UNL-Lunabotics/Electrical-26-27/README.md

# Electrical-26-27
Electrical's pcb projects and documentation.
