UNL-Lunabotics/Electrical-26-27/Motor_Driver/Motor_Driver.kicad_pcb

## KiCad design Motor_Driver/Motor_Driver.kicad_pcb (2026-11-14)

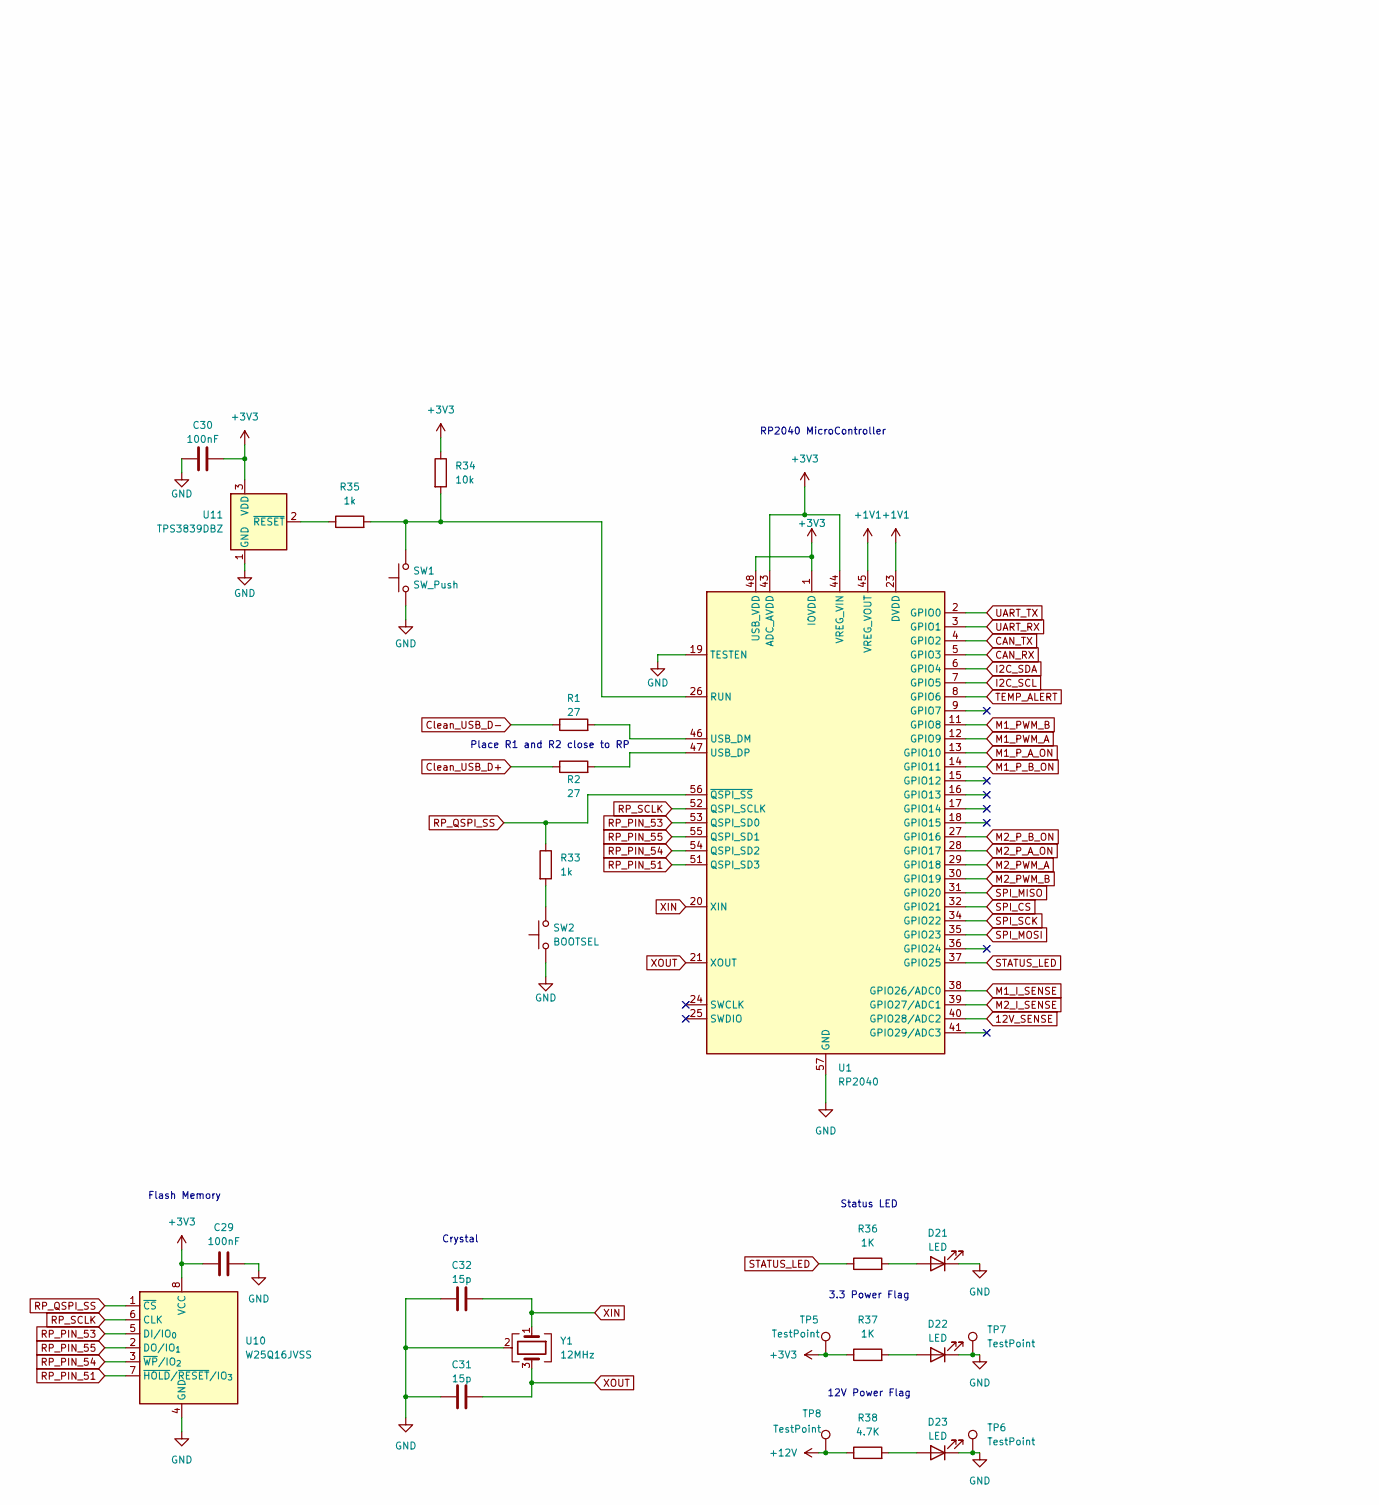
[picture p1: schematic Motor_Driver.kicad_sch, part in row 1, column 1]

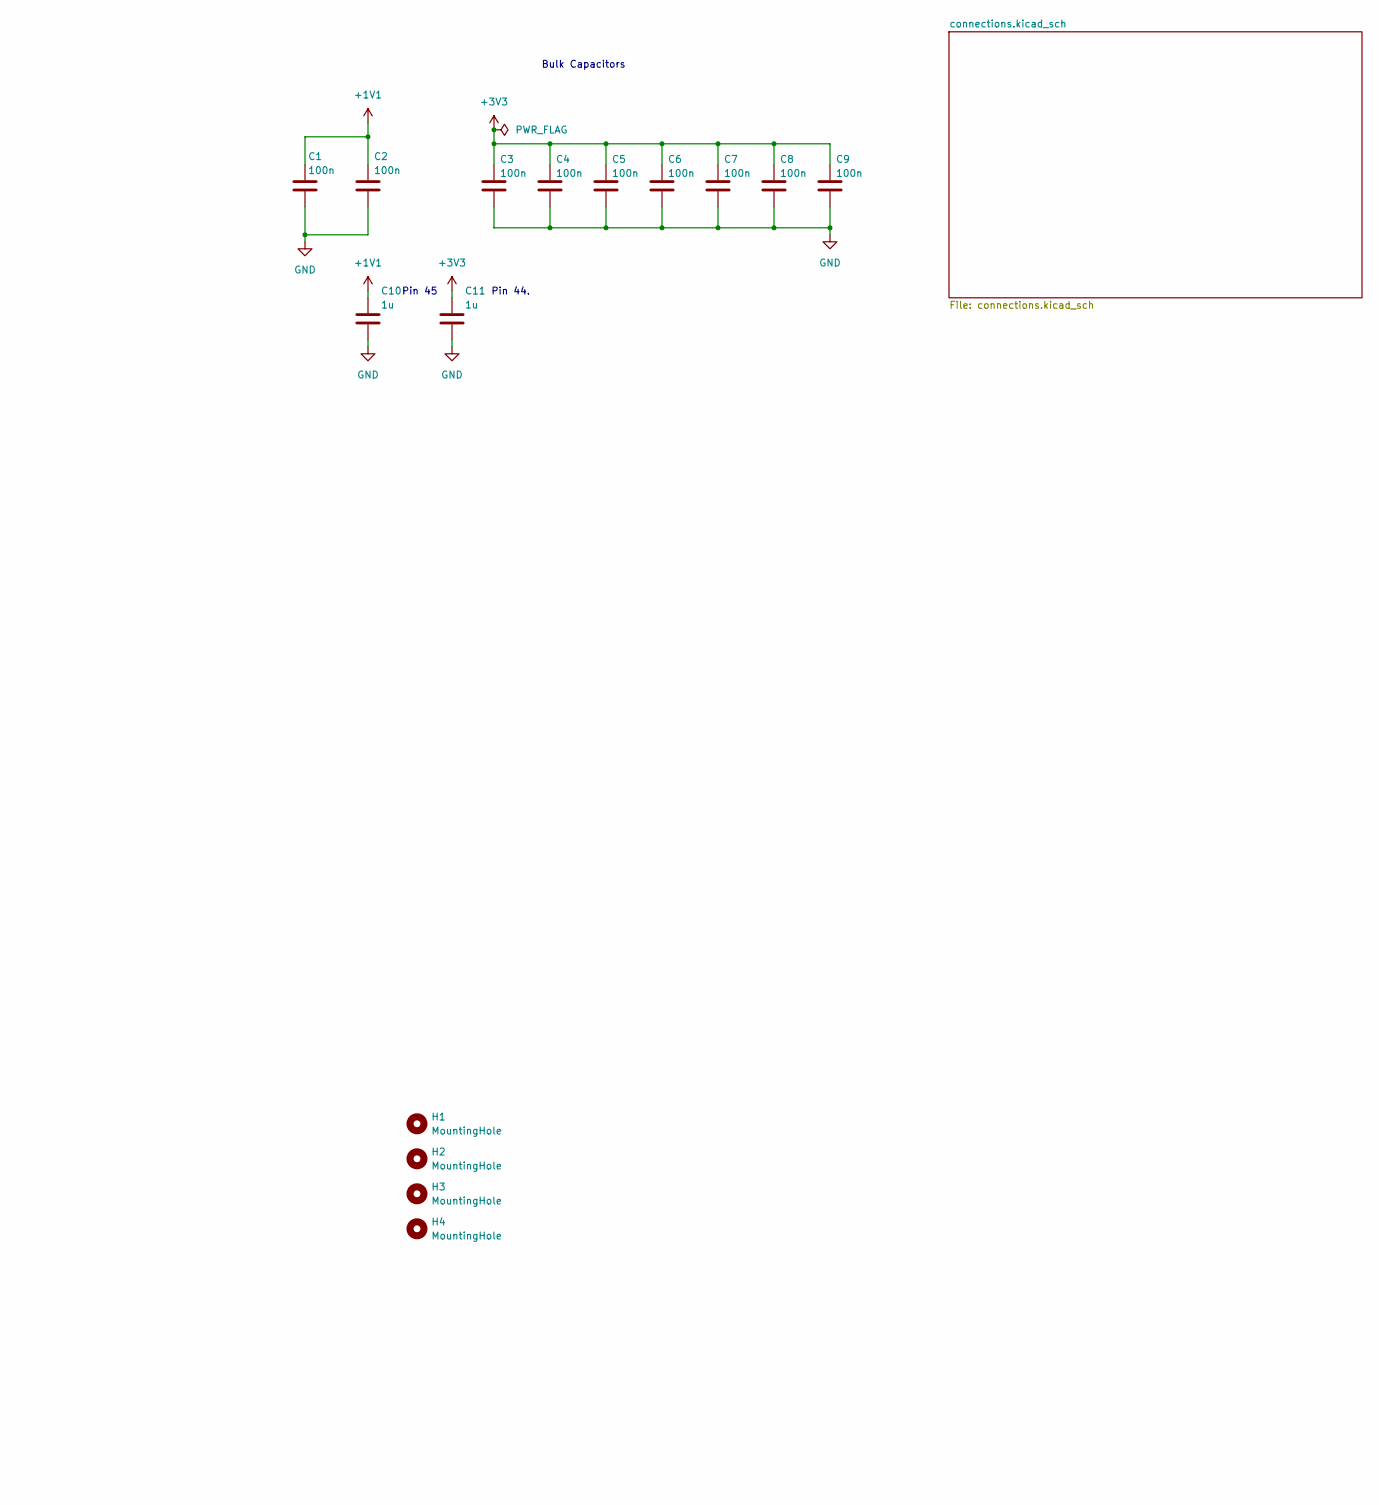
[picture p2: schematic Motor_Driver.kicad_sch, part in row 1, column 2]

Parts:
C1, C2, C3, C4, C5, C6, C7, C8, C9: 100n; C_0805_2012Metric
C10, C11: 1u; C_0805_2012Metric
C29, C30: 100nF; C_0805_2012Metric
C31, C32: 15p; C_0805_2012Metric
D21, D22, D23: LED; LED_0805_2012Metric
H1, H2, H3, H4: MountingHole; MountingHole_3.2mm_M3
R1, R2: 27; R_0805_2012Metric
R33, R35: 1k; R_0805_2012Metric
R34: 10k; R_0805_2012Metric
R36, R37: 1K; R_0805_2012Metric
R38: 4.7K; R_0805_2012Metric
SW1: SW_Push; SW_PUSH_6mm
SW2: BOOTSEL; SW_PUSH_6mm
TP5, TP6, TP7, TP8: TestPoint; TestPoint_Pad_D1.5mm
U1: RP2040; QFN-56-1EP_7x7mm_P0.4mm_EP3.2x3.2mm
U10: W25Q16JVSS; SOIC-8_5.3x5.3mm_P1.27mm
U11: TPS3839DBZ; SOT-23
Y1: 12MHz; Crystal_SMD_3225-4Pin_3.2x2.5mm

Connections:
12V_SENSE: U1.40 (GPIO28/ADC2); also elsewhere on the board
+1V1: C1.1, C2.1, C10.1, U1.23 (DVDD), U1.45 (VREG_VOUT), U1.50 (DVDD)
+3V3: C3.1, C4.1, C5.1, C6.1, C7.1, C8.1, C9.1, C11.1, C29.1, C30.1, R34.1, R37.1, TP5.1 (1_1), U1.1 (IOVDD), U1.10 (IOVDD), U1.22 (IOVDD), U1.33 (IOVDD), U1.42 (IOVDD), U1.43 (ADC_AVDD), U1.44 (VREG_VIN), U1.48 (USB_VDD), U1.49 (IOVDD), U10.8 (VCC), U11.3 (VDD); also elsewhere on the board
+12V: R38.1, TP8.1 (1_1); also elsewhere on the board
CAN_RX: U1.5 (GPIO3); also elsewhere on the board
CAN_TX: U1.4 (GPIO2); also elsewhere on the board
Clean_USB_D+: R2.1; also elsewhere on the board
Clean_USB_D-: R1.1; also elsewhere on the board
GND: C1.2, C2.2, C3.2, C4.2, C5.2, C6.2, C7.2, C8.2, C9.2, C10.2, C11.2, C29.2, C30.2, C31.1, C32.1, D21.1 (K), D22.1 (K), D23.1 (K), SW1.1, SW2.1, TP6.1 (1_1), TP7.1 (1_1), U1.19 (TESTEN), U1.57 (GND), U10.4 (GND), U11.1 (GND), Y1.2 (G), Y1.4 (G); also elsewhere on the board
I2C_SCL: U1.7 (GPIO5); also elsewhere on the board
I2C_SDA: U1.6 (GPIO4); also elsewhere on the board
M1_I_SENSE: U1.38 (GPIO26/ADC0); also elsewhere on the board
M1_PWM_A: U1.12 (GPIO9); also elsewhere on the board
M1_PWM_B: U1.11 (GPIO8); also elsewhere on the board
M1_P_A_ON: U1.13 (GPIO10); also elsewhere on the board
M1_P_B_ON: U1.14 (GPIO11); also elsewhere on the board
M2_I_SENSE: U1.39 (GPIO27/ADC1); also elsewhere on the board
M2_PWM_A: U1.29 (GPIO18); also elsewhere on the board
M2_PWM_B: U1.30 (GPIO19); also elsewhere on the board
M2_P_A_ON: U1.28 (GPIO17); also elsewhere on the board
M2_P_B_ON: U1.27 (GPIO16); also elsewhere on the board
unnamed: D21.2 (A), R36.2
unnamed: D22.2 (A), R37.2
unnamed: D23.2 (A), R38.2
unnamed: R33.2, SW2.2
unnamed: R34.2, R35.2, SW1.2, U1.26 (RUN)
unnamed: R1.2, U1.46 (USB_DM)
unnamed: R2.2, U1.47 (USB_DP)
unnamed: R35.1, U11.2 (~RESET)
RP_PIN_51: U1.51 (QSPI_SD3), U10.7 (~HOLD/~RESET/IO_{3})
RP_PIN_53: U1.53 (QSPI_SD0), U10.5 (DI/IO_{0})
RP_PIN_54: U1.54 (QSPI_SD2), U10.3 (~WP/IO_{2})
RP_PIN_55: U1.55 (QSPI_SD1), U10.2 (DO/IO_{1})
RP_QSPI_SS: R33.1, U1.56 (~QSPI_SS), U10.1 (~CS)
RP_SCLK: U1.52 (QSPI_SCLK), U10.6 (CLK)
SPI_CS: U1.32 (GPIO21); also elsewhere on the board
SPI_MISO: U1.31 (GPIO20); also elsewhere on the board
SPI_MOSI: U1.35 (GPIO23); also elsewhere on the board
SPI_SCK: U1.34 (GPIO22); also elsewhere on the board
STATUS_LED: R36.1, U1.37 (GPIO25)
TEMP_ALERT: U1.8 (GPIO6); also elsewhere on the board
UART_RX: U1.3 (GPIO1); also elsewhere on the board
UART_TX: U1.2 (GPIO0); also elsewhere on the board
XIN: C32.2, U1.20 (XIN), Y1.1
XOUT: C31.2, U1.21 (XOUT), Y1.3

Notes on the sheet:
Pin 44.
12V Power Flag
Pin 45
Bulk Capacitors
Status LED
3.3 Power Flag
Flash Memory
Crystal
RP2040 MicroController
Place R1 and R2 close to RP

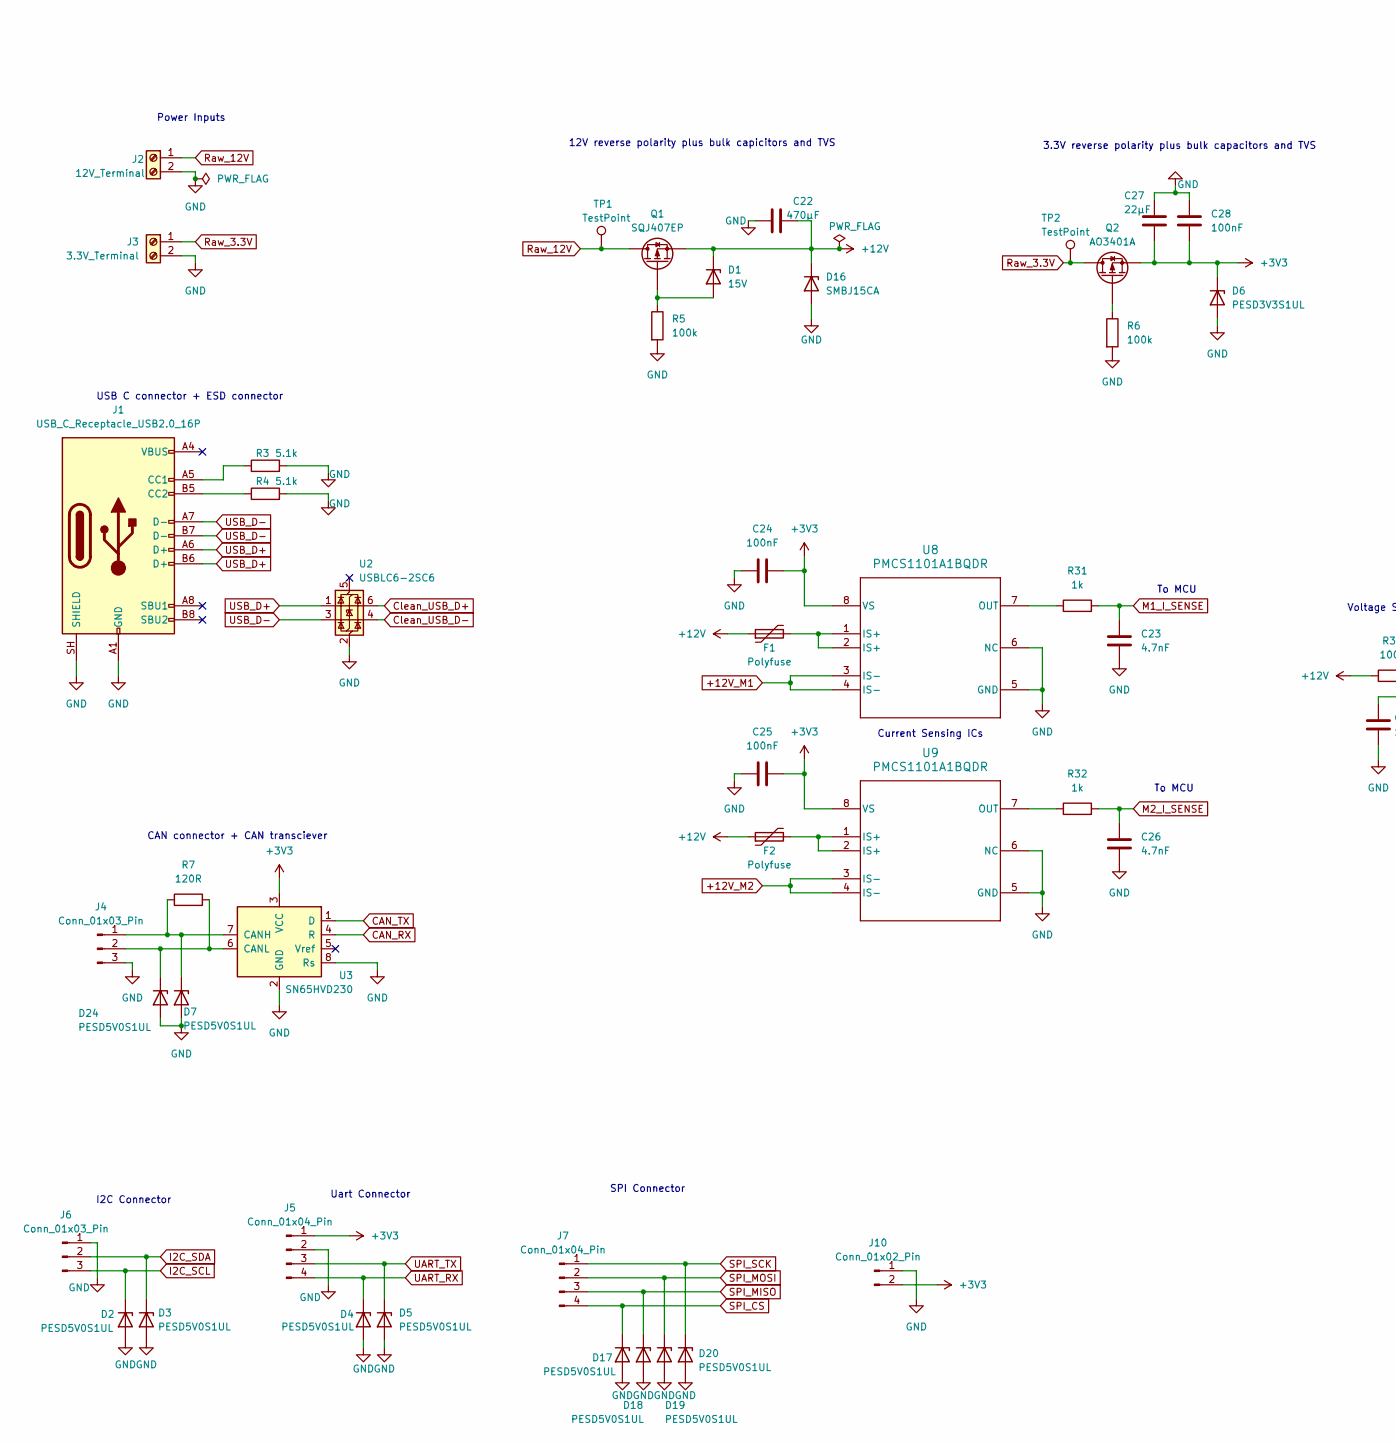
[picture p3: schematic connections.kicad_sch, part in row 1, column 1]

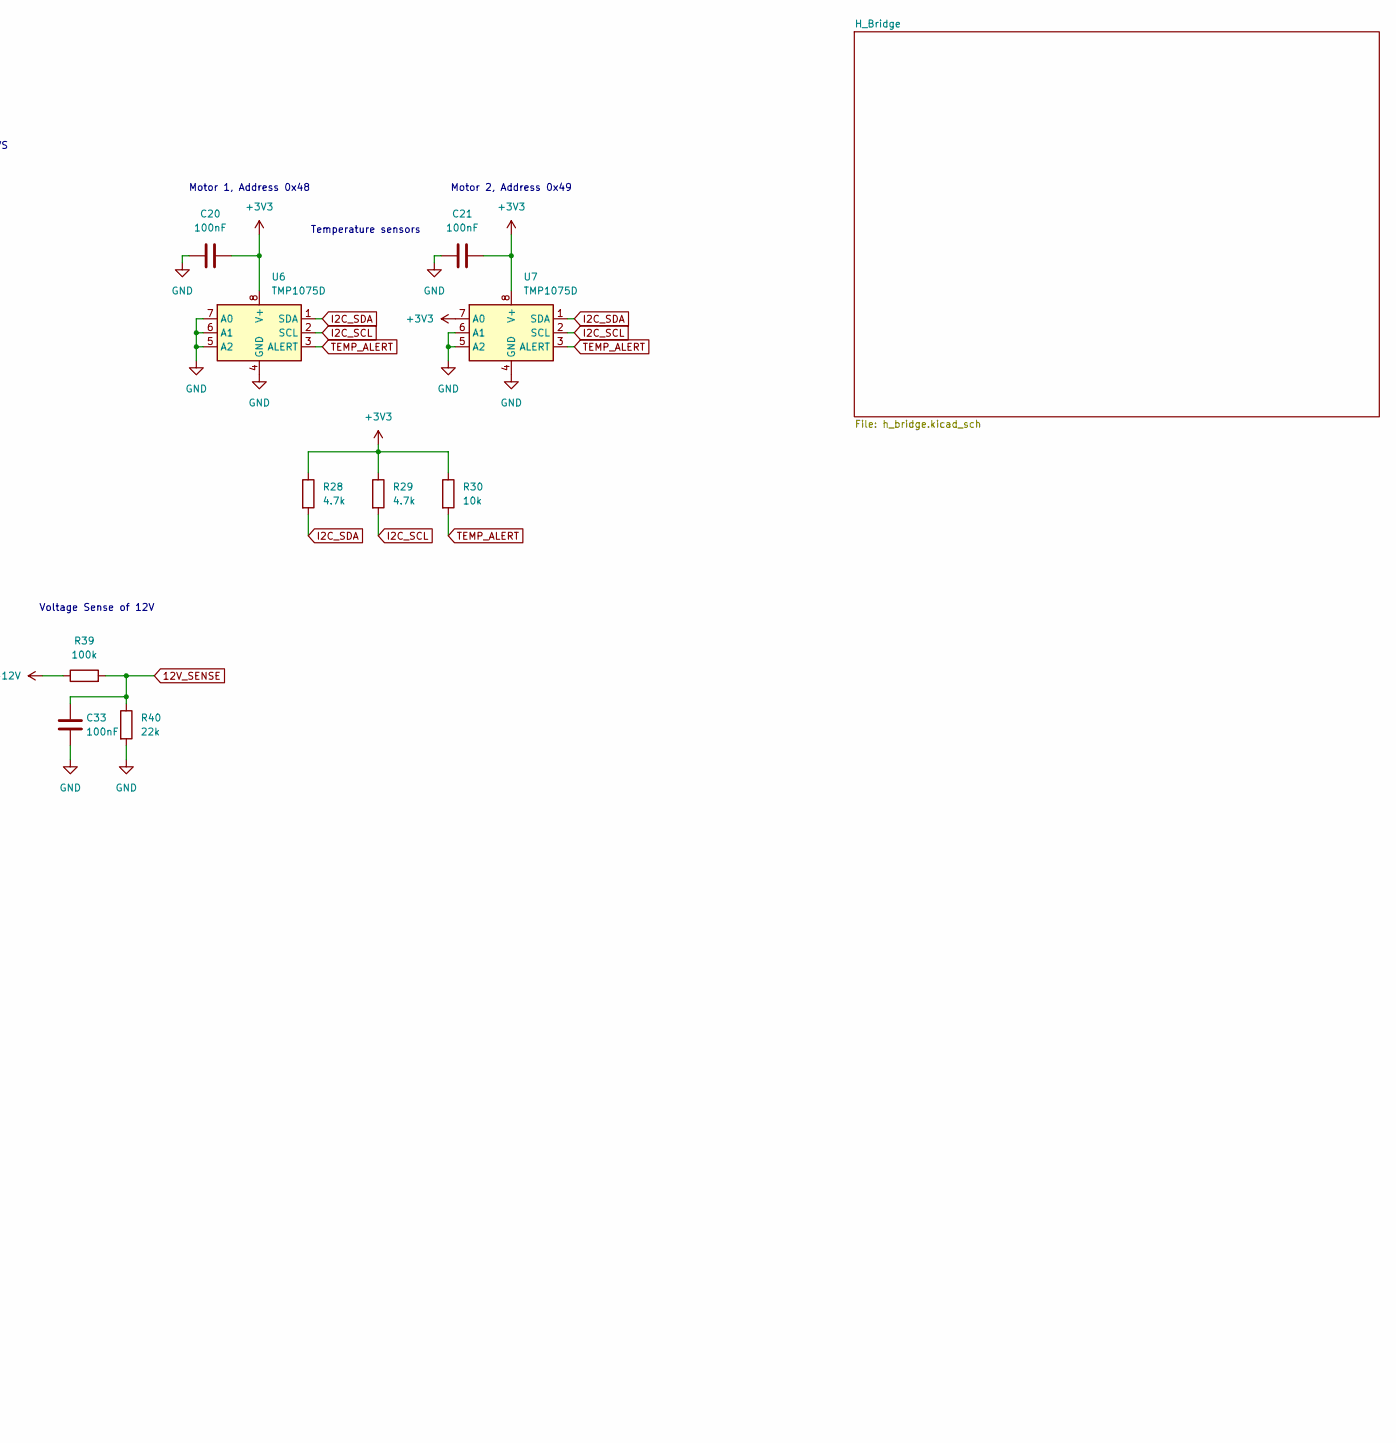
[picture p4: schematic connections.kicad_sch, part in row 1, column 2]

Parts:
C20, C21, C24, C25, C28, C33: 100nF; C_0805_2012Metric
C22: 470μF; CP_Elec_10x10.5
C23, C26: 4.7nF; C_0805_2012Metric
C27: 22μF; C_0805_2012Metric
D1: 15V; D_SOD-123
D2, D3, D4, D5, D7, D17, D18, D19, D20, D24: PESD5V0S1UL; D_SOD-882
D6: PESD3V3S1UL; D_SOD-882
D16: SMBJ15CA; D_SMB
F1, F2: Polyfuse; Fuse_Mount
J1: USB_C_Receptacle_USB2.0_16P; USB_C_Receptacle_GCT_USB4105-xx-A_16P_TopMnt_Horizontal
J2: 12V_Terminal; TerminalBlock_MaiXu_MX126-5.0-02P_1x02_P5.00mm
J3: 3.3V_Terminal; TerminalBlock_MaiXu_MX126-5.0-02P_1x02_P5.00mm
J4, J6: Conn_01x03_Pin; JST_XH_B3B-XH-A_1x03_P2.50mm_Vertical
J5, J7: Conn_01x04_Pin; JST_XH_B4B-XH-A_1x04_P2.50mm_Vertical
J10: Conn_01x02_Pin; JST_XH_B2B-XH-A_1x02_P2.50mm_Vertical
Q1: SQJ407EP; PowerPAK_SO-8_Single_SGD
Q2: AO3401A; SOT-23_GSD
R3, R4: 5.1k; R_0805_2012Metric
R5, R6, R39: 100k; R_0805_2012Metric
R7: 120R; R_0805_2012Metric
R28, R29: 4.7k; R_0805_2012Metric
R30: 10k; R_0805_2012Metric
R31, R32: 1k; R_0805_2012Metric
R40: 22k; R_0805_2012Metric
TP1, TP2: TestPoint; TestPoint_Pad_D1.5mm
U2: USBLC6-2SC6; SOT-23-6
U3: SN65HVD230; SOIC-8_3.9x4.9mm_P1.27mm
U6, U7: TMP1075D; SO-8_3.9x4.9mm_P1.27mm
U8, U9: PMCS1101A1BQDR; D0008A_N

Connections:
12V_SENSE: C33.1, R39.2, R40.1; also elsewhere on the board
+3V3: C20.2, C21.2, C24.2, C25.2, C27.2, C28.2, D6.1 (K), J5.1, J10.2, Q2.S, R28.1, R29.1, R30.1, U3.3 (VCC), U6.8 (V+), U7.7 (A0), U7.8 (V+), U8.8 (VS), U9.8 (VS); also elsewhere on the board
+12V: C22.2, D1.1 (K), D16.1 (K), F1.1, F2.1, Q1.S, R39.1; also elsewhere on the board
+12V_M1: U8.3 (IS-), U8.4 (IS-); also elsewhere on the board
+12V_M2: U9.3 (IS-), U9.4 (IS-); also elsewhere on the board
CAN_RX: U3.4 (R); also elsewhere on the board
CAN_TX: U3.1 (D); also elsewhere on the board
Clean_USB_D+: U2.6 (I/O1); also elsewhere on the board
Clean_USB_D-: U2.4 (I/O2); also elsewhere on the board
GND: C20.1, C21.1, C22.1, C23.2, C24.1, C25.1, C26.2, C27.1, C28.1, C33.2, D2.2 (A), D3.2 (A), D4.2 (A), D5.2 (A), D6.2 (A), D7.2 (A), D16.2 (A), D17.2 (A), D18.2 (A), D19.2 (A), D20.2 (A), D24.2 (A), J1.A1 (GND), J1.A12 (GND), J1.B1 (GND), J1.B12 (GND), J1.SH (SHIELD), J2.2, J3.2, J4.3, J5.2, J6.1, J10.1, R3.2, R4.2, R5.2, R6.2, R40.2, U2.2 (GND), U3.2 (GND), U3.8 (Rs), U6.4 (GND), U6.5 (A2), U6.6 (A1), U6.7 (A0), U7.4 (GND), U7.5 (A2), U7.6 (A1), U8.5 (GND), U8.6 (NC), U9.5 (GND), U9.6 (NC); also elsewhere on the board
I2C_SCL: D2.1 (K), J6.3, R29.2, U6.2 (SCL), U7.2 (SCL); also elsewhere on the board
I2C_SDA: D3.1 (K), J6.2, R28.2, U6.1 (SDA), U7.1 (SDA); also elsewhere on the board
M1_I_SENSE: C23.1, R31.2; also elsewhere on the board
M2_I_SENSE: C26.1, R32.2; also elsewhere on the board
unnamed: D1.2 (A), Q1.G, R5.1
unnamed: D7.1 (K), J4.1, R7.1, U3.7 (CANH)
unnamed: D24.1 (K), J4.2, R7.2, U3.6 (CANL)
unnamed: F1.2, U8.1 (IS+), U8.2 (IS+)
unnamed: F2.2, U9.1 (IS+), U9.2 (IS+)
unnamed: J1.A5 (CC1), R3.1
unnamed: J1.B5 (CC2), R4.1
unnamed: Q2.G, R6.1
unnamed: R31.1, U8.7 (OUT)
unnamed: R32.1, U9.7 (OUT)
Raw_3.3V: J3.1, Q2.D, TP2.1 (1_1)
Raw_12V: J2.1, Q1.D, TP1.1 (1_1)
SPI_CS: D17.1 (K), J7.4; also elsewhere on the board
SPI_MISO: D18.1 (K), J7.3; also elsewhere on the board
SPI_MOSI: D19.1 (K), J7.2; also elsewhere on the board
SPI_SCK: D20.1 (K), J7.1; also elsewhere on the board
TEMP_ALERT: R30.2, U6.3 (ALERT), U7.3 (ALERT); also elsewhere on the board
UART_RX: D4.1 (K), J5.4; also elsewhere on the board
UART_TX: D5.1 (K), J5.3; also elsewhere on the board
USB_D+: J1.A6 (D+), J1.B6 (D+), U2.1 (I/O1)
USB_D-: J1.A7 (D-), J1.B7 (D-), U2.3 (I/O2)

Notes on the sheet:
Temperature sensors
Motor 1, Address 0x48
I2C Connector
To MCU
USB C connector + ESD connector
3.3V reverse polarity plus bulk capacitors and TVS
12V reverse polarity plus bulk capicitors and TVS
Current Sensing ICs
Motor 2, Address 0x49
CAN connector + CAN transciever
Power Inputs
Voltage Sense of 12V
SPI Connector
Uart Connector

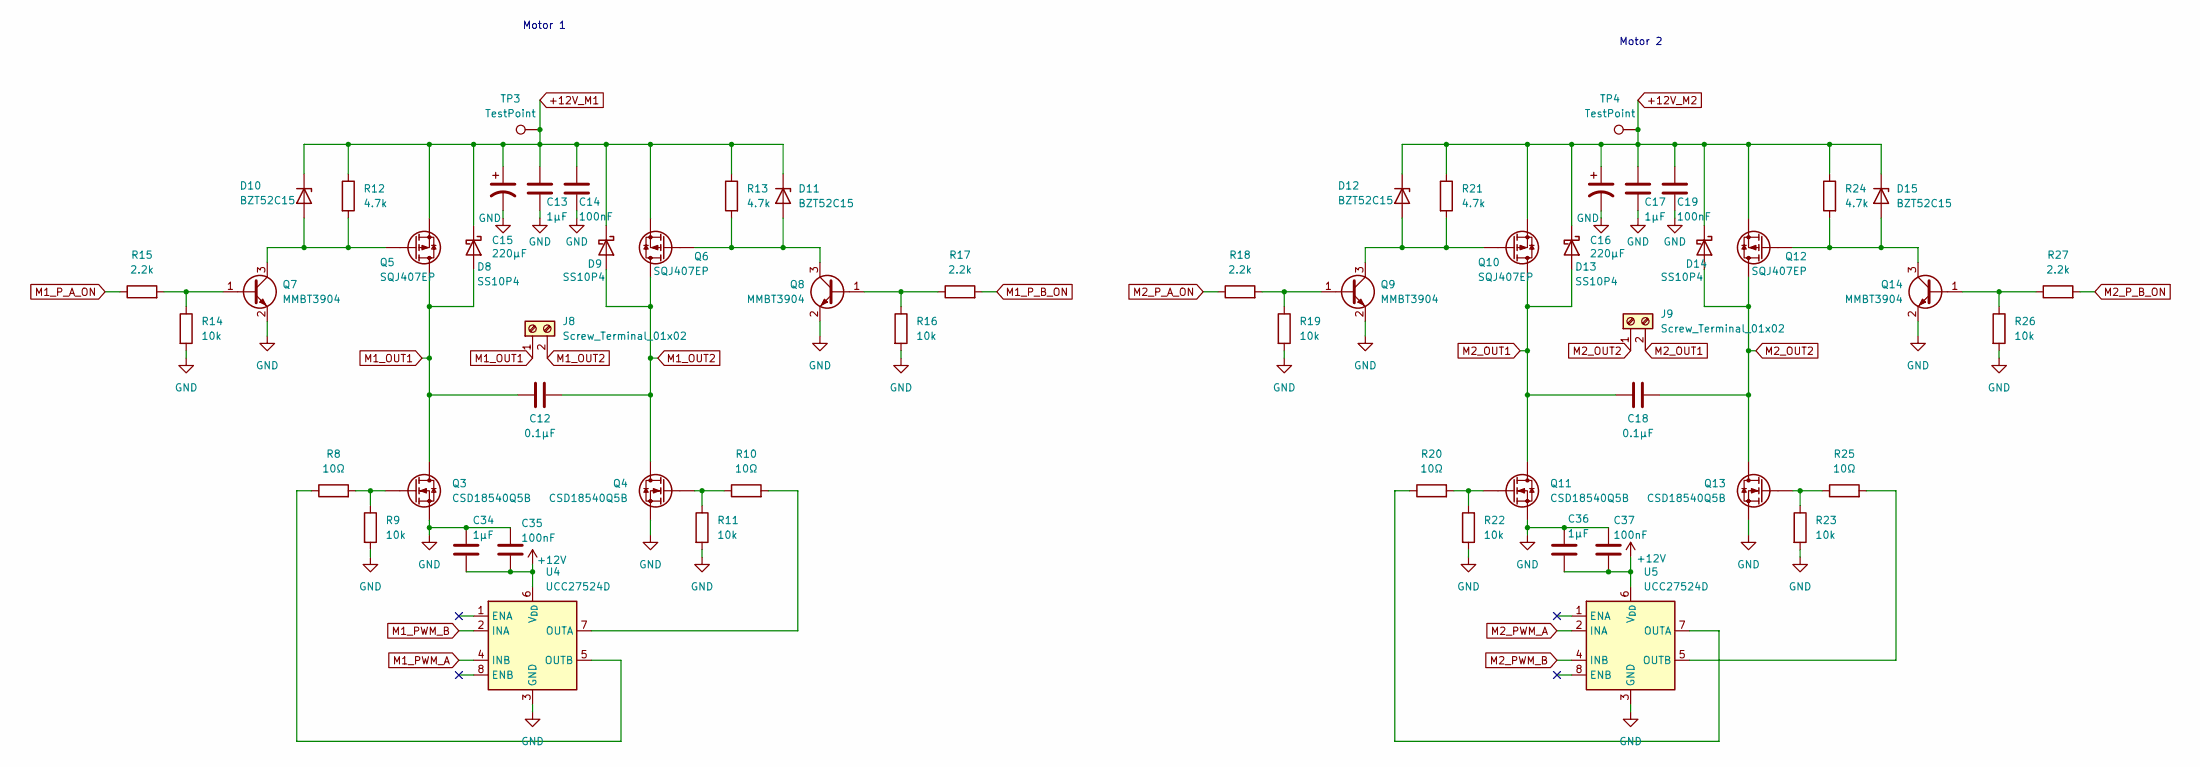
[picture p5: schematic h_bridge.kicad_sch]

Parts:
C12, C18: 0.1μF; C_0805_2012Metric
C13, C17, C34, C36: 1μF; C_0805_2012Metric
C14, C19, C35, C37: 100nF; C_0805_2012Metric
C15, C16: 220μF; CP_Elec_8x10.5
D8, D9, D13, D14: SS10P4; TO-277A_SS10P4_K-tab
D10, D11, D12, D15: BZT52C15; D_SOD-123
J8, J9: Screw_Terminal_01x02; TerminalBlock_MaiXu_MX126-5.0-02P_1x02_P5.00mm
Q3, Q4, Q11, Q13: CSD18540Q5B; TDSON-8-1_SGD
Q5, Q6, Q10, Q12: SQJ407EP; PowerPAK_SO-8_Single_SGD
Q7, Q8, Q9, Q14: MMBT3904; SOT-23
R8, R10, R20, R25: 10Ω; R_0805_2012Metric
R9, R11, R14, R16, R19, R22, R23, R26: 10k; R_0805_2012Metric
R12, R13, R21, R24: 4.7k; R_0805_2012Metric
R15, R17, R18, R27: 2.2k; R_0805_2012Metric
TP3, TP4: TestPoint; TestPoint_Pad_D1.5mm
U4, U5: UCC27524D; SOIC-8_3.9x4.9mm_P1.27mm

Connections:
+12V: C34.2, C35.2, C36.2, C37.2, U4.6 (V_{DD}), U5.6 (V_{DD}); also elsewhere on the board
+12V_M1: C13.1, C14.1, C15.1, D8.1 (K), D9.1 (K), D10.1 (K), D11.1 (K), Q5.S, Q6.S, R12.1, R13.1, TP3.1 (1_1); also elsewhere on the board
+12V_M2: C16.1, C17.1, C19.1, D12.1 (K), D13.1 (K), D14.1 (K), D15.1 (K), Q10.S, Q12.S, R21.1, R24.1, TP4.1 (1_1); also elsewhere on the board
GND: C13.2, C14.2, C15.2, C16.2, C17.2, C19.2, C34.1, C35.1, C36.1, C37.1, Q3.S, Q4.S, Q7.2 (E), Q8.2 (E), Q9.2 (E), Q11.S, Q13.S, Q14.2 (E), R9.2, R11.2, R14.2, R16.2, R19.2, R22.2, R23.2, R26.2, U4.3 (GND), U5.3 (GND); also elsewhere on the board
M1_OUT1: C12.1, D8.2 (A), J8.1, Q3.D, Q5.D
M1_OUT2: C12.2, D9.2 (A), J8.2, Q4.D, Q6.D
M1_PWM_A: U4.4 (INB); also elsewhere on the board
M1_PWM_B: U4.2 (INA); also elsewhere on the board
M1_P_A_ON: R15.1; also elsewhere on the board
M1_P_B_ON: R17.2; also elsewhere on the board
M2_OUT1: C18.1, D13.2 (A), J9.2, Q10.D, Q11.D
M2_OUT2: C18.2, D14.2 (A), J9.1, Q12.D, Q13.D
M2_PWM_A: U5.2 (INA); also elsewhere on the board
M2_PWM_B: U5.4 (INB); also elsewhere on the board
M2_P_A_ON: R18.1; also elsewhere on the board
M2_P_B_ON: R27.2; also elsewhere on the board
unnamed: D10.2 (A), Q5.G, Q7.3 (C), R12.2
unnamed: D11.2 (A), Q6.G, Q8.3 (C), R13.2
unnamed: D12.2 (A), Q9.3 (C), Q10.G, R21.2
unnamed: D15.2 (A), Q12.G, Q14.3 (C), R24.2
unnamed: Q3.G, R8.2, R9.1
unnamed: Q4.G, R10.1, R11.1
unnamed: Q7.1 (B), R14.1, R15.2
unnamed: Q8.1 (B), R16.1, R17.1
unnamed: Q9.1 (B), R18.2, R19.1
unnamed: Q11.G, R20.2, R22.1
unnamed: Q13.G, R23.1, R25.1
unnamed: Q14.1 (B), R26.1, R27.1
unnamed: R10.2, U4.7 (OUTA)
unnamed: R8.1, U4.5 (OUTB)
unnamed: R20.1, U5.7 (OUTA)
unnamed: R25.2, U5.5 (OUTB)

Notes on the sheet:
Motor 1
Motor 2

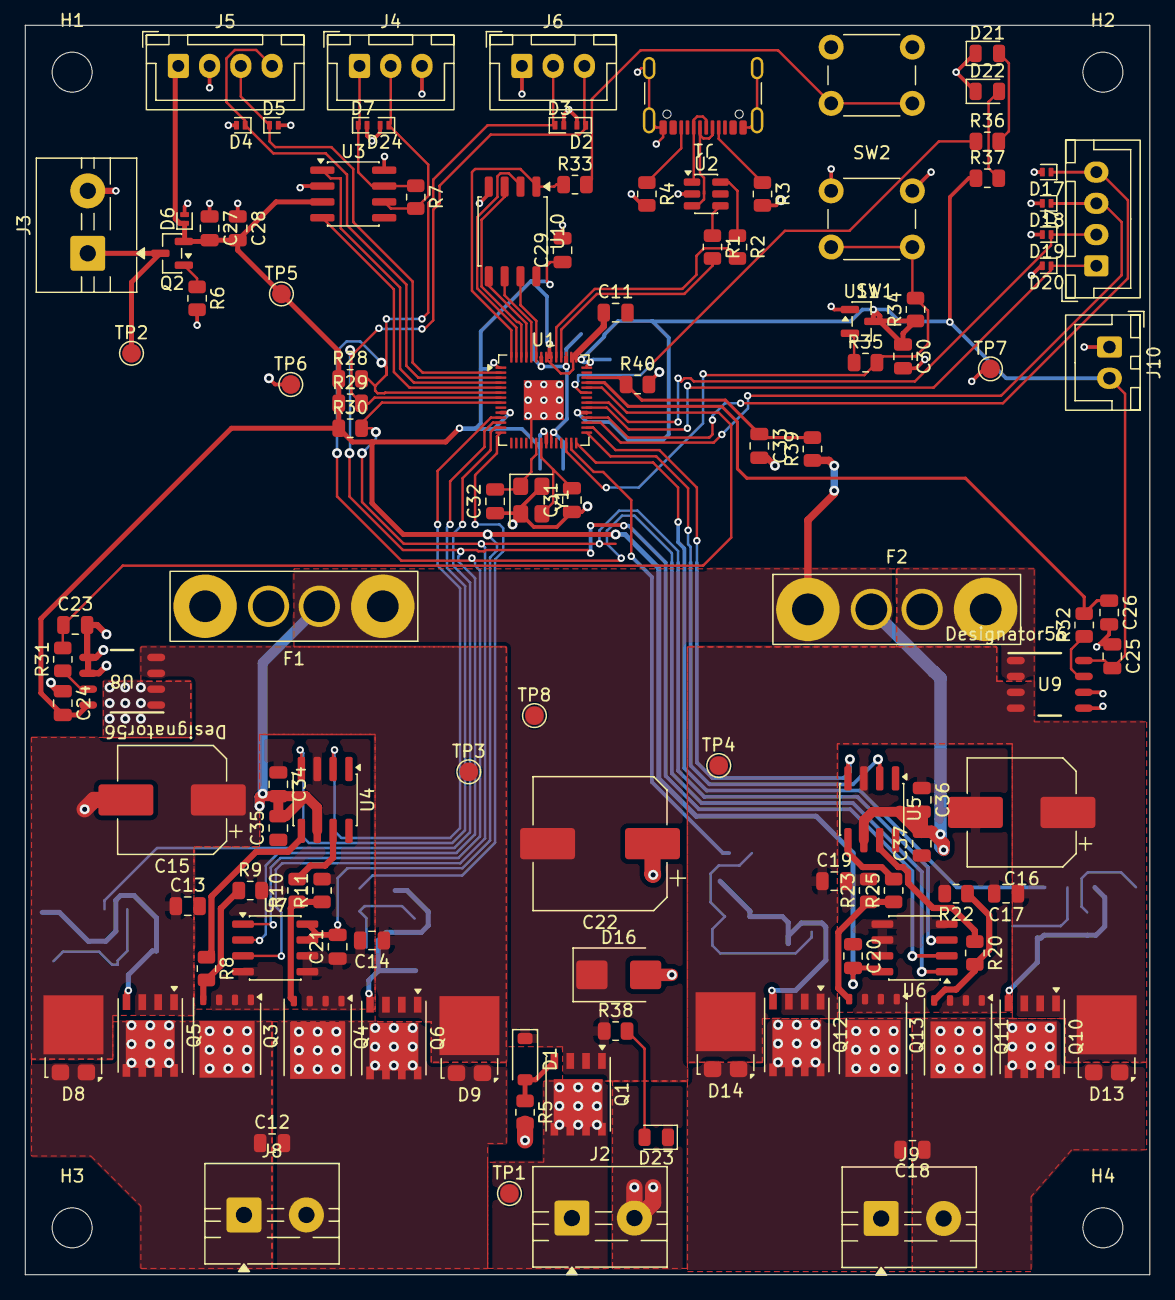
[picture p6: board Motor_Driver.kicad_pcb from above]

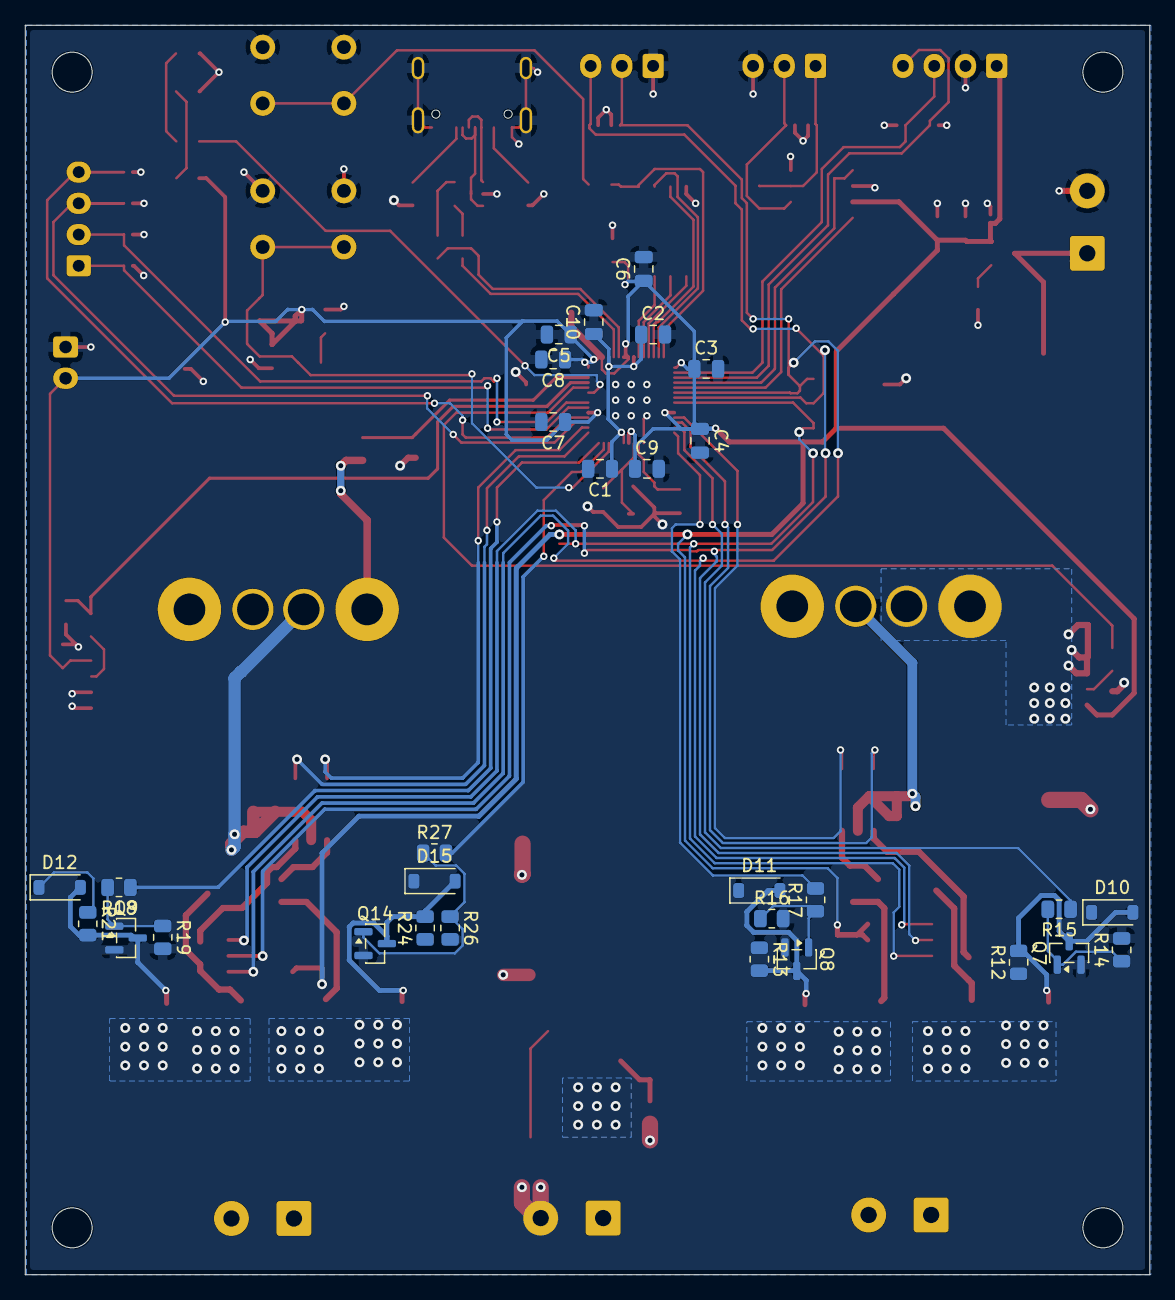
[picture p7: board Motor_Driver.kicad_pcb from below]

Board: 2 copper layers, 90.0 x 100.0 mm, 153 parts (30 on the bottom side), 81 nets.
