UNL-Lunabotics/Electrical-26-27/Motor Driver/Motor_Driver/Motor_Driver.kicad_sch

## KiCad design Motor Driver/Motor_Driver/Motor_Driver.kicad_sch (2026-10-11)

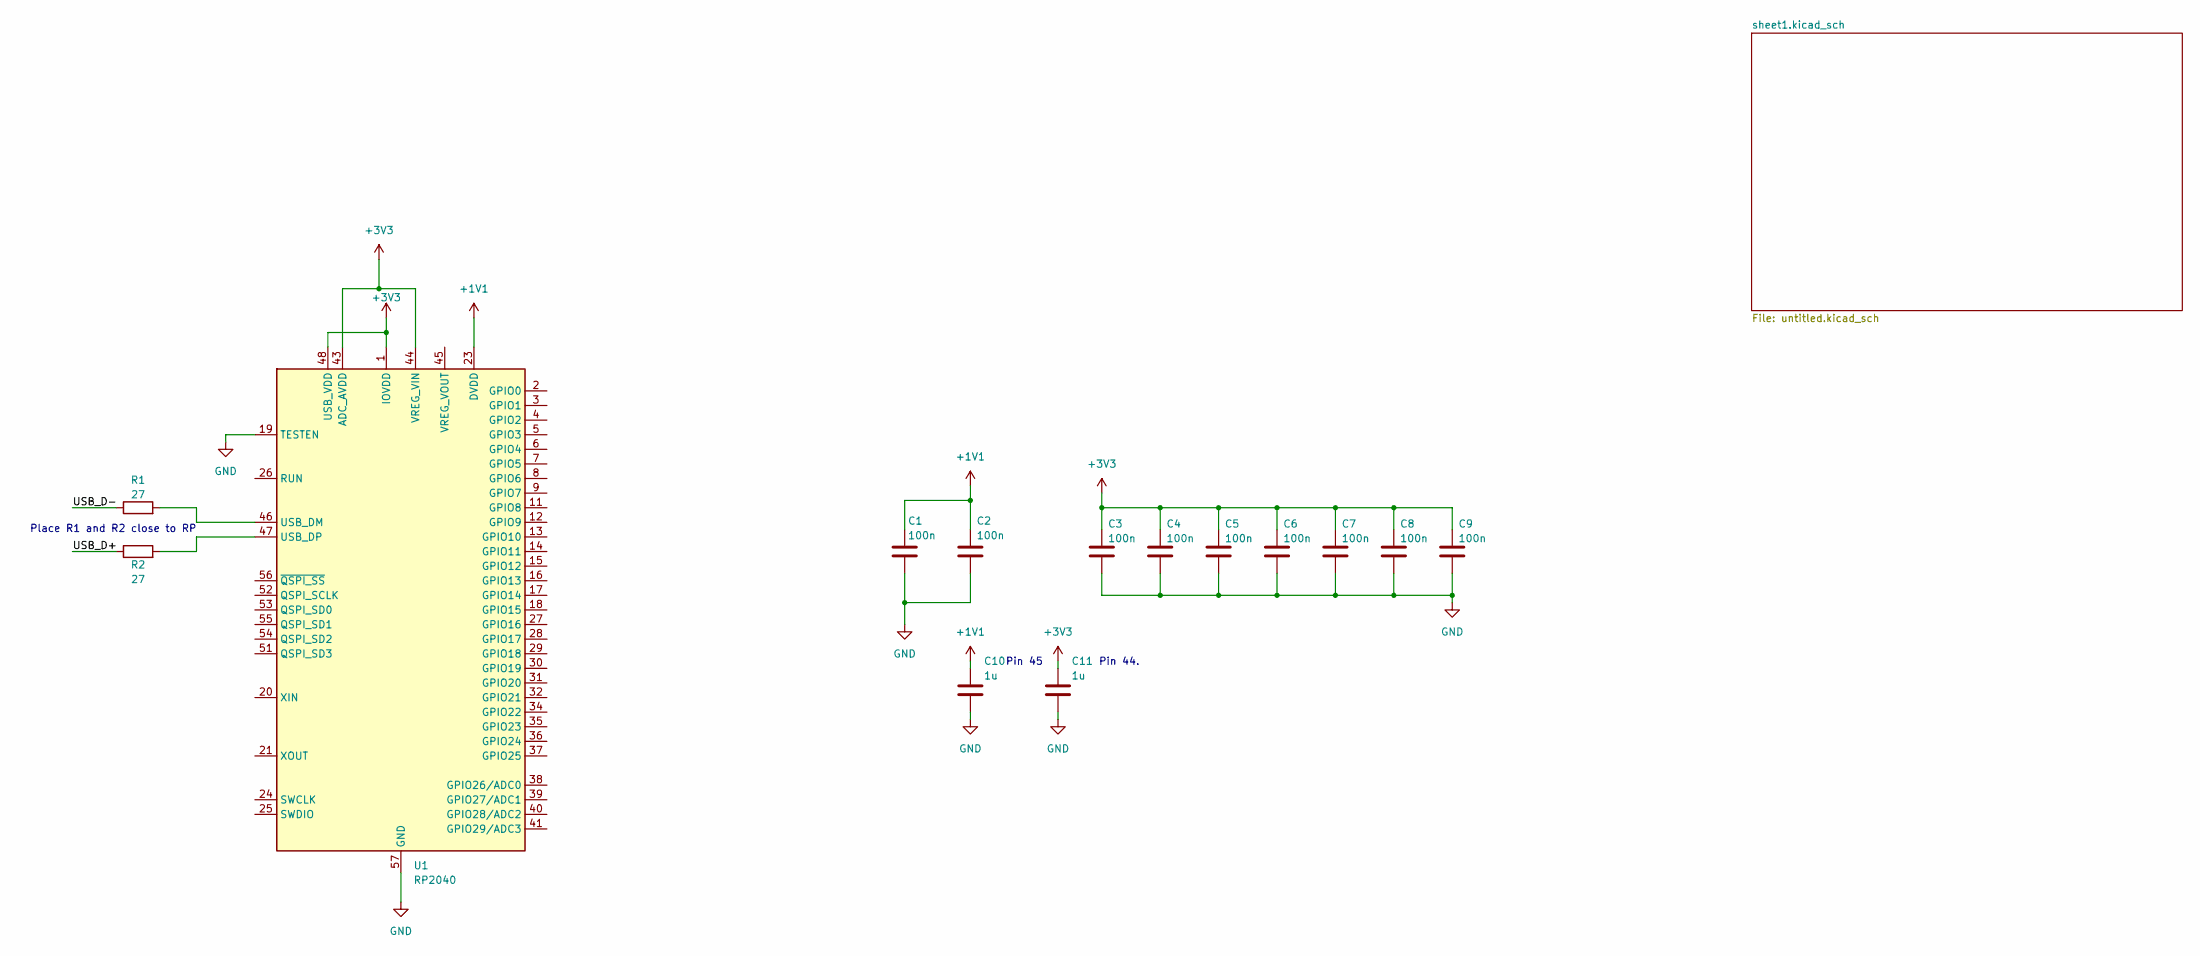
[picture p8: schematic Motor_Driver.kicad_sch]

Parts:
C1, C2, C3, C4, C5, C6, C7, C8, C9: 100n
C10, C11: 1u
R1, R2: 27
U1: RP2040; QFN-56-1EP_7x7mm_P0.4mm_EP3.2x3.2mm

Connections:
+1V1: C1.1, C2.1, C10.1, U1.23 (DVDD), U1.50 (DVDD)
+3V3: C3.1, C4.1, C5.1, C6.1, C7.1, C8.1, C9.1, C11.1, U1.1 (IOVDD), U1.10 (IOVDD), U1.22 (IOVDD), U1.33 (IOVDD), U1.42 (IOVDD), U1.43 (ADC_AVDD), U1.44 (VREG_VIN), U1.48 (USB_VDD), U1.49 (IOVDD)
GND: C1.2, C2.2, C3.2, C4.2, C5.2, C6.2, C7.2, C8.2, C9.2, C10.2, C11.2, U1.19 (TESTEN), U1.57 (GND)
unnamed: R1.2, U1.46 (USB_DM)
unnamed: R2.2, U1.47 (USB_DP)
USB_D+: R2.1
USB_D-: R1.1

Notes on the sheet:
Pin 44.
Pin 45
Place R1 and R2 close to RP
