UNL-Lunabotics/Electrical-26-27/Motor Driver/Motor_Driver/untitled.kicad_sch

## KiCad design Motor Driver/Motor_Driver/untitled.kicad_sch (2026-10-11)

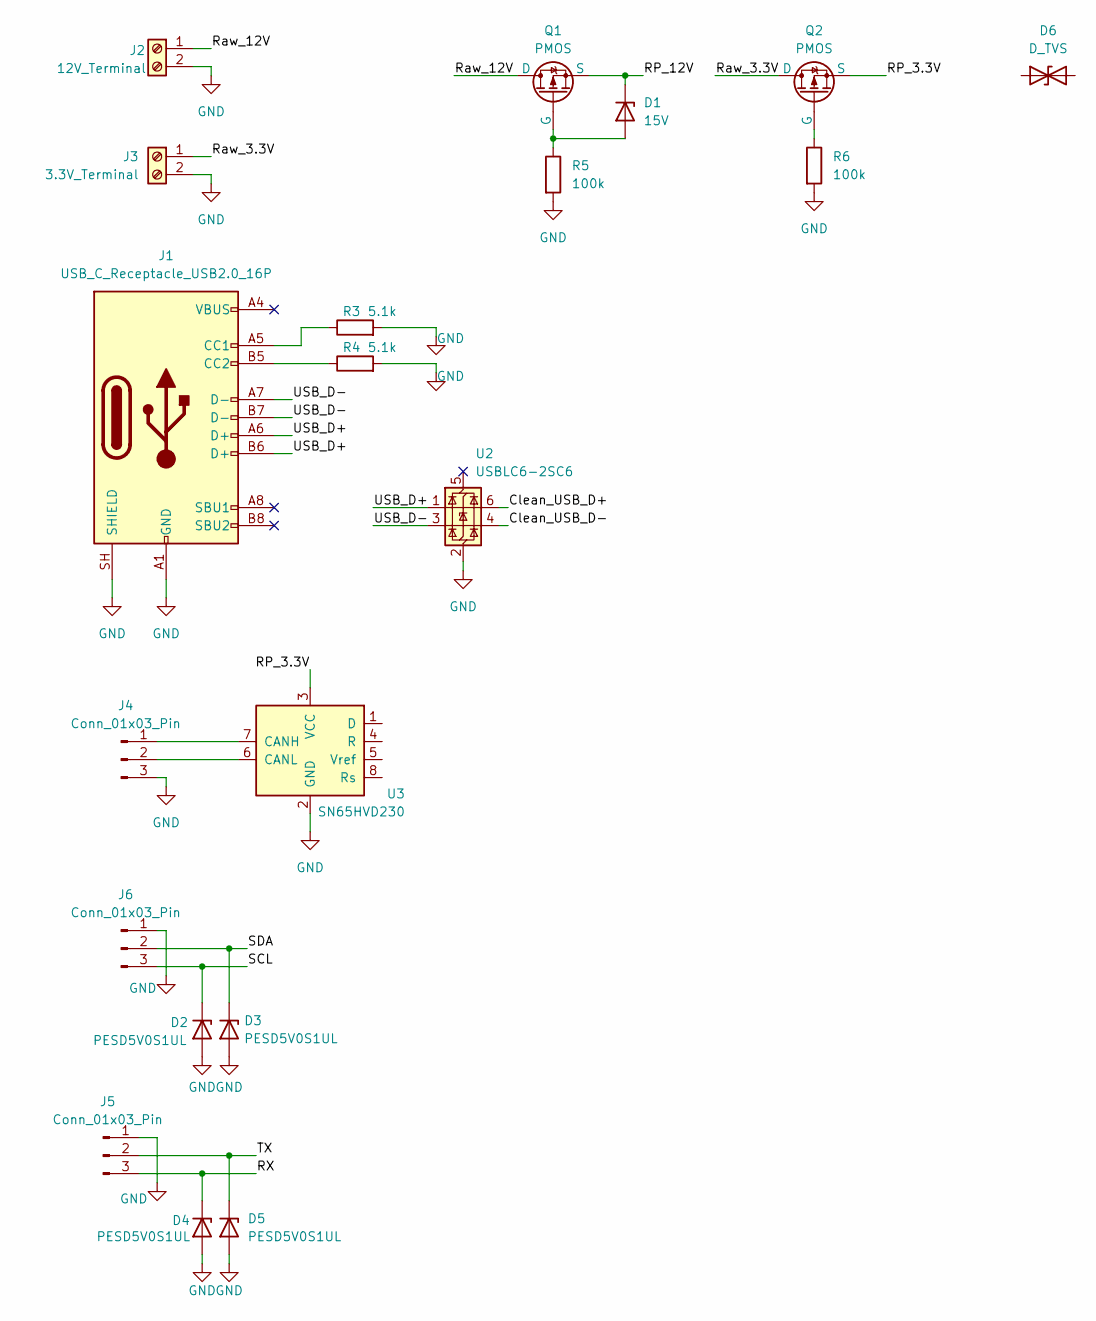
[picture p9: schematic untitled.kicad_sch]

Parts:
D1: 15V
D2, D3, D4, D5: PESD5V0S1UL; D_SOD-882
D6: D_TVS
J1: USB_C_Receptacle_USB2.0_16P
J2: 12V_Terminal
J3: 3.3V_Terminal
J4, J5, J6: Conn_01x03_Pin
Q1, Q2: PMOS
R3, R4: 5.1k
R5, R6: 100k
U2: USBLC6-2SC6; SOT-23-6
U3: SN65HVD230; SOIC-8_3.9x4.9mm_P1.27mm

Connections:
Clean_USB_D+: U2.6 (I/O1)
Clean_USB_D-: U2.4 (I/O2)
GND: D2.2 (A), D3.2 (A), D4.2 (A), D5.2 (A), J1.A1 (GND), J1.A12 (GND), J1.B1 (GND), J1.B12 (GND), J1.SH (SHIELD), J2.2, J3.2, J4.3, J5.1, J6.1, R3.2, R4.2, R5.2, R6.2, U2.2 (GND), U3.2 (GND)
unnamed: D1.2 (A), Q1.2 (G), R5.1
unnamed: J1.A4 (VBUS), J1.A9 (VBUS), J1.B4 (VBUS), J1.B9 (VBUS)
unnamed: J1.A5 (CC1), R3.1
unnamed: J1.B5 (CC2), R4.1
unnamed: J4.1, U3.7 (CANH)
unnamed: J4.2, U3.6 (CANL)
unnamed: Q2.2 (G), R6.1
RP_3.3V: Q2.3 (S), U3.3 (VCC)
RP_12V: D1.1 (K), Q1.3 (S)
RX: D4.1 (K), J5.3
Raw_3.3V: J3.1, Q2.1 (D)
Raw_12V: J2.1, Q1.1 (D)
SCL: D2.1 (K), J6.3
SDA: D3.1 (K), J6.2
TX: D5.1 (K), J5.2
USB_D+: J1.A6 (D+), J1.B6 (D+), U2.1 (I/O1)
USB_D-: J1.A7 (D-), J1.B7 (D-), U2.3 (I/O2)
