UNL-Lunabotics/Electrical-26-27/(commit log)

2026-10-11 Initial Motor Driver Commit
2026-10-22 Schematic Changes 90% done
2026-10-22 Potential Finished Schematic Before Placements
2026-10-23 Hopefully fully finished schematic. Ready for PCB placement.
2026-11-08 Starting on PCB placements, 3.3V Region mostly finished. Need to start on 12v and h bridge regions next.
2026-11-11 Everything Placed. Onto all the power and ground pours plus routing, some components need to be slightly moved but i will fix them soon.
2026-11-14 Like 98.99 Percent done. Just need to add stitching vias to some section pours, and also connect some of the 12V parts on the bottom side. Super quick finishing touches, but components and everything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
